philippewu/pid-lab/app/Thread.py

import sys
import traceback

from PySide6.QtCore import QRunnable, Slot, Signal, QObject


# this class allows the worker to emit signals
class WorkerSignals(QObject):
    finished = Signal()
    error = Signal(tuple)
    result = Signal(object)
    progress = Signal(int)


# this class creates a worker that can run a function in a CPU threadpool
class Worker(QRunnable):

    def __init__(self, fn, *args, **kwargs):
        super(Worker, self).__init__()

        self.fn = fn
        self.args = args
        self.kwargs = kwargs
        self.signals = WorkerSignals()
    
    @Slot()
    def run(self):
        try:
            result = self.fn(*self.args, **self.kwargs)
        except:
            traceback.print_exc()
            exctype, value = sys.exc_info()[:2]
            self.signals.error.emit((exctype, value, traceback.format_exc()))
        else:
            self.signals.result.emit(result)
        finally:
            self.signals.finished.emit()
